thunderkeys/Reaper/Usermods/KilianBLRD/Switchwire x carriage/STL/Klicky Servo Dock Shortened arms/drive_arm_front_shortened.stl

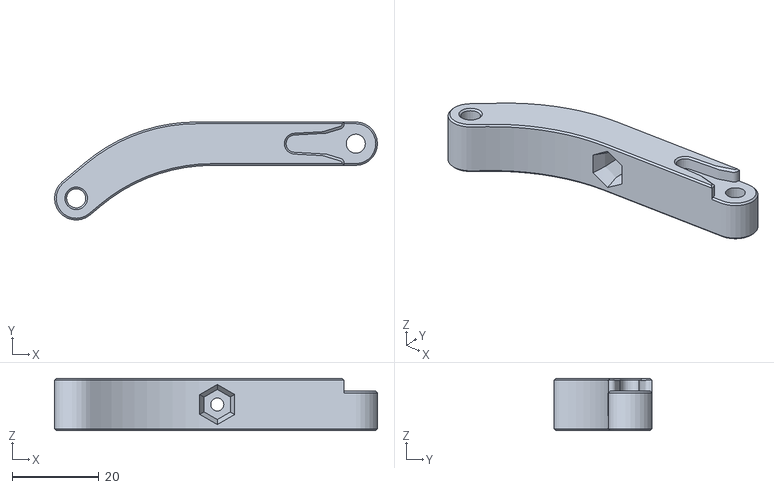
[picture p13: CAD file, 2026-07-01]
Usermods/KilianBLRD/Switchwire x carriage/STL/Klicky Servo Dock Shortened arms/drive_arm_front_shortened.stl
74.4 x 22.6 x 12.0
