thunderkeys/Reaper/Usermods/KilianBLRD/Switchwire x carriage/STL/Printed Klicky Probe x carriage/x_carriage_rear.stl

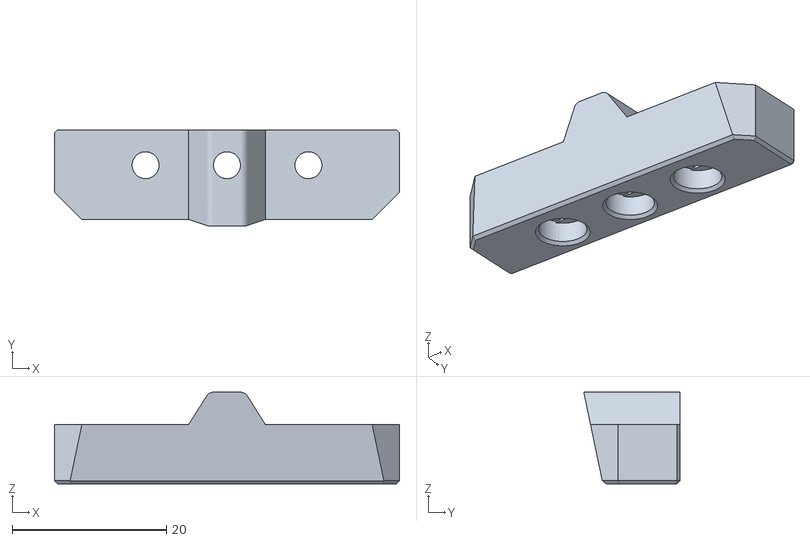
[picture p14: CAD file, 2026-07-01]
Usermods/KilianBLRD/Switchwire x carriage/STL/Printed Klicky Probe x carriage/x_carriage_rear.stl
44.8 x 12.5 x 11.9
