thunderkeys/Reaper/Usermods/KilianBLRD/Switchwire x carriage/STL/Printed Klicky Probe x carriage/x_carriage_belt_clip_x2.stl

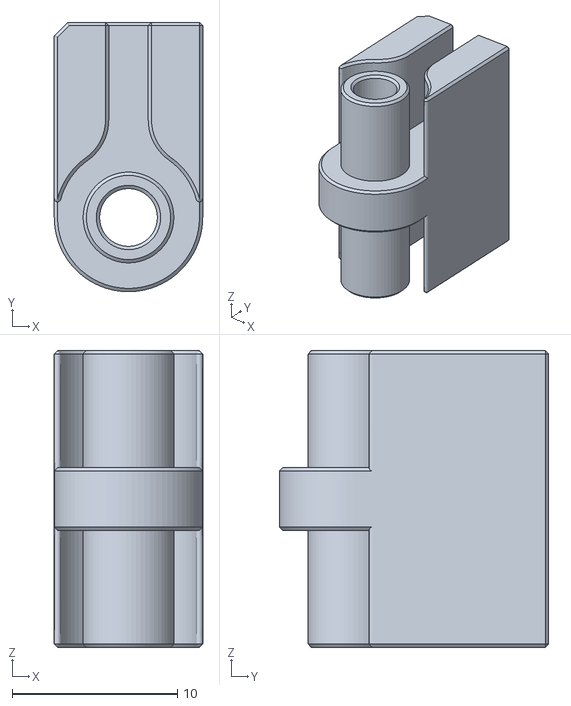
[picture p15: CAD file, 2026-07-01]
Usermods/KilianBLRD/Switchwire x carriage/STL/Printed Klicky Probe x carriage/x_carriage_belt_clip_x2.stl
9.00 x 16.3 x 18.0
