thunderkeys/Reaper/Usermods/KilianBLRD/Switchwire x carriage/STL/Printed Klicky Probe x carriage/x_carriage_klicky.stl

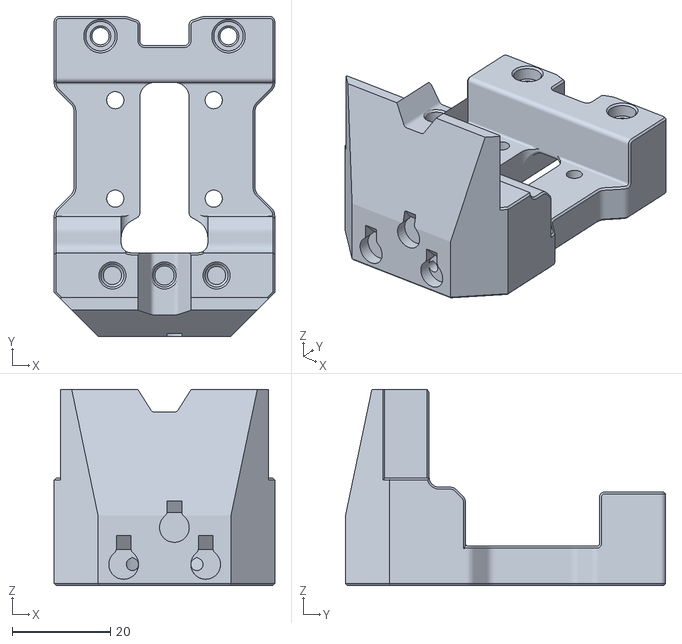
[picture p16: CAD file, 2026-07-01]
Usermods/KilianBLRD/Switchwire x carriage/STL/Printed Klicky Probe x carriage/x_carriage_klicky.stl
44.8 x 65.0 x 39.8
