thunderkeys/Reaper/(list of files, cad)

Other CAD files:
Usermods/KilianBLRD/Switchwire x carriage/STL/Klicky Servo Dock Shortened arms/drive_arm_back_shortened.stl
